vlevieux/Metronome/Modules/tick_1ms.vhd

library IEEE;
use IEEE.STD_LOGIC_1164.ALL;
use IEEE.std_logic_unsigned.all;

entity TICK_1ms is
	Port (clk : in STD_LOGIC;
		Tick : out STD_LOGIC);
end TICK_1ms;

architecture Behavioral of TICK_1ms is
	signal Q: STD_LOGIC_VECTOR(15 downto 0):=(OTHERS => '0');


	begin
	process(CLK)begin
		if clk'event and clk='1' then
			if(Q<"1100001101010000")then
				Q<=Q+1;
			else
				Q<=(OTHERS =>'0'); 
			end if;
		end if;
	end process;
	Tick<= '0'  when Q<"1100001101010000"  else '1';
end Behavioral; 
